emergencyhamnet/meshcore-pi-hat/images/README.md

# Board Images

Add clear photographs and renders here. Identify the board revision and distinguish a render
from a fabricated assembly. Remove private labels and location metadata where appropriate.
