emergencyhamnet/meshcore-pi-hat/LICENSING.md

# Non-Commercial Shared Hardware

## Licence And Scope

Unless explicitly marked otherwise, original project hardware design files, fabrication
outputs, documentation and images are licensed under
[CC BY-NC-SA 4.0](https://creativecommons.org/licenses/by-nc-sa/4.0/legalcode).
See [LICENSE](LICENSE) for the licence notice and official terms.

This permits sharing and adaptations for non-commercial purposes, with attribution and
the applicable ShareAlike requirements. NonCommercial has the definition in the official
licence; it is not simply a restriction on profit. This is not an open-source hardware
licence because commercial use is restricted.

For attribution, retain the project name, credited creators and this repository link:
https://github.com/emergencyhamnet/meshcore-pi-hat
Identify modifications and retain existing notices when sharing adaptations.

## Separate Fabrication Permission

In addition to the CC licence, the project licensors permit users to make or commission
physical boards for their own non-commercial use, to the extent the licensors control
the rights needed for that activity. A fabrication or assembly service may reproduce
and use the supplied design files solely to fulfil those non-commercial build orders
and may charge for its manufacturing services.

This additional permission does not authorise a supplier to use the design to produce
its own commercial product line or to manufacture stock for general commercial resale.
Commercial exploitation outside the CC licence and this additional permission requires
separate permission from the relevant rights holders. Contact the maintainers through a
GitHub issue for commercial-licensing enquiries; do not post confidential information.

This permission is separate from the unmodified CC licence. It does not restrict rights
already granted by that licence or by applicable law. It grants no patent or trademark
rights; obtain any other required rights independently. Manufacturing and the boundary
of non-commercial use may require legal review for a particular activity.

## Third-Party Material And Software

Third-party symbols, footprints, models and other assets retain their own licences.
Do not relabel them as CC BY-NC-SA unless the rights holder permits it. Mark exclusions
and retain their attribution and licence notices. Link to datasheets if permission to
redistribute them is unavailable.

Firmware and software in the separate MeshCore Pi port repository retain their own
licences. This hardware licence does not change their terms.

Contributors must have the rights to publish their submissions under the applicable
terms and identify any third-party material. No CAD files are included in the initial
scaffold; review ownership and notices as files are added.
