emergencyhamnet/meshcore-pi-hat/design/circuit.pdf

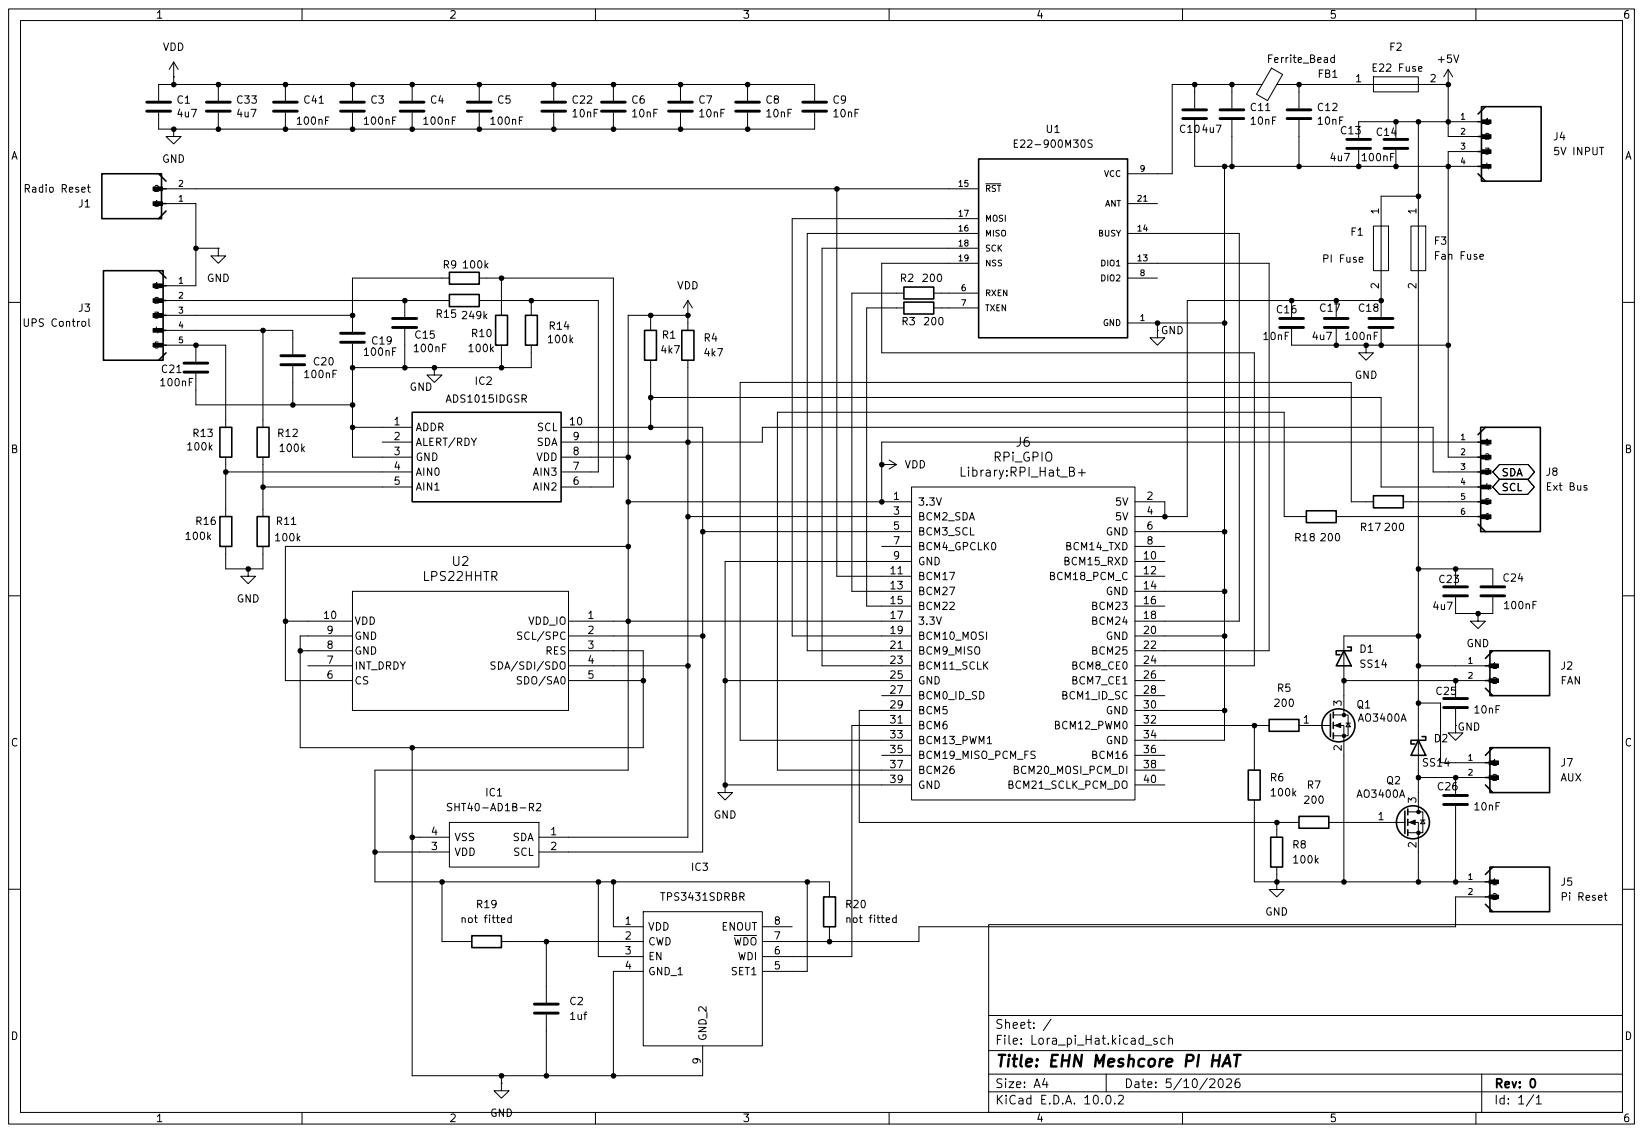
[picture p1: page 1]
