emergencyhamnet/meshcore-pi-hat/design/Lora_pi_Hat.kicad_pcb

## KiCad design design/Lora_pi_Hat.kicad_pcb (2026-11-01)

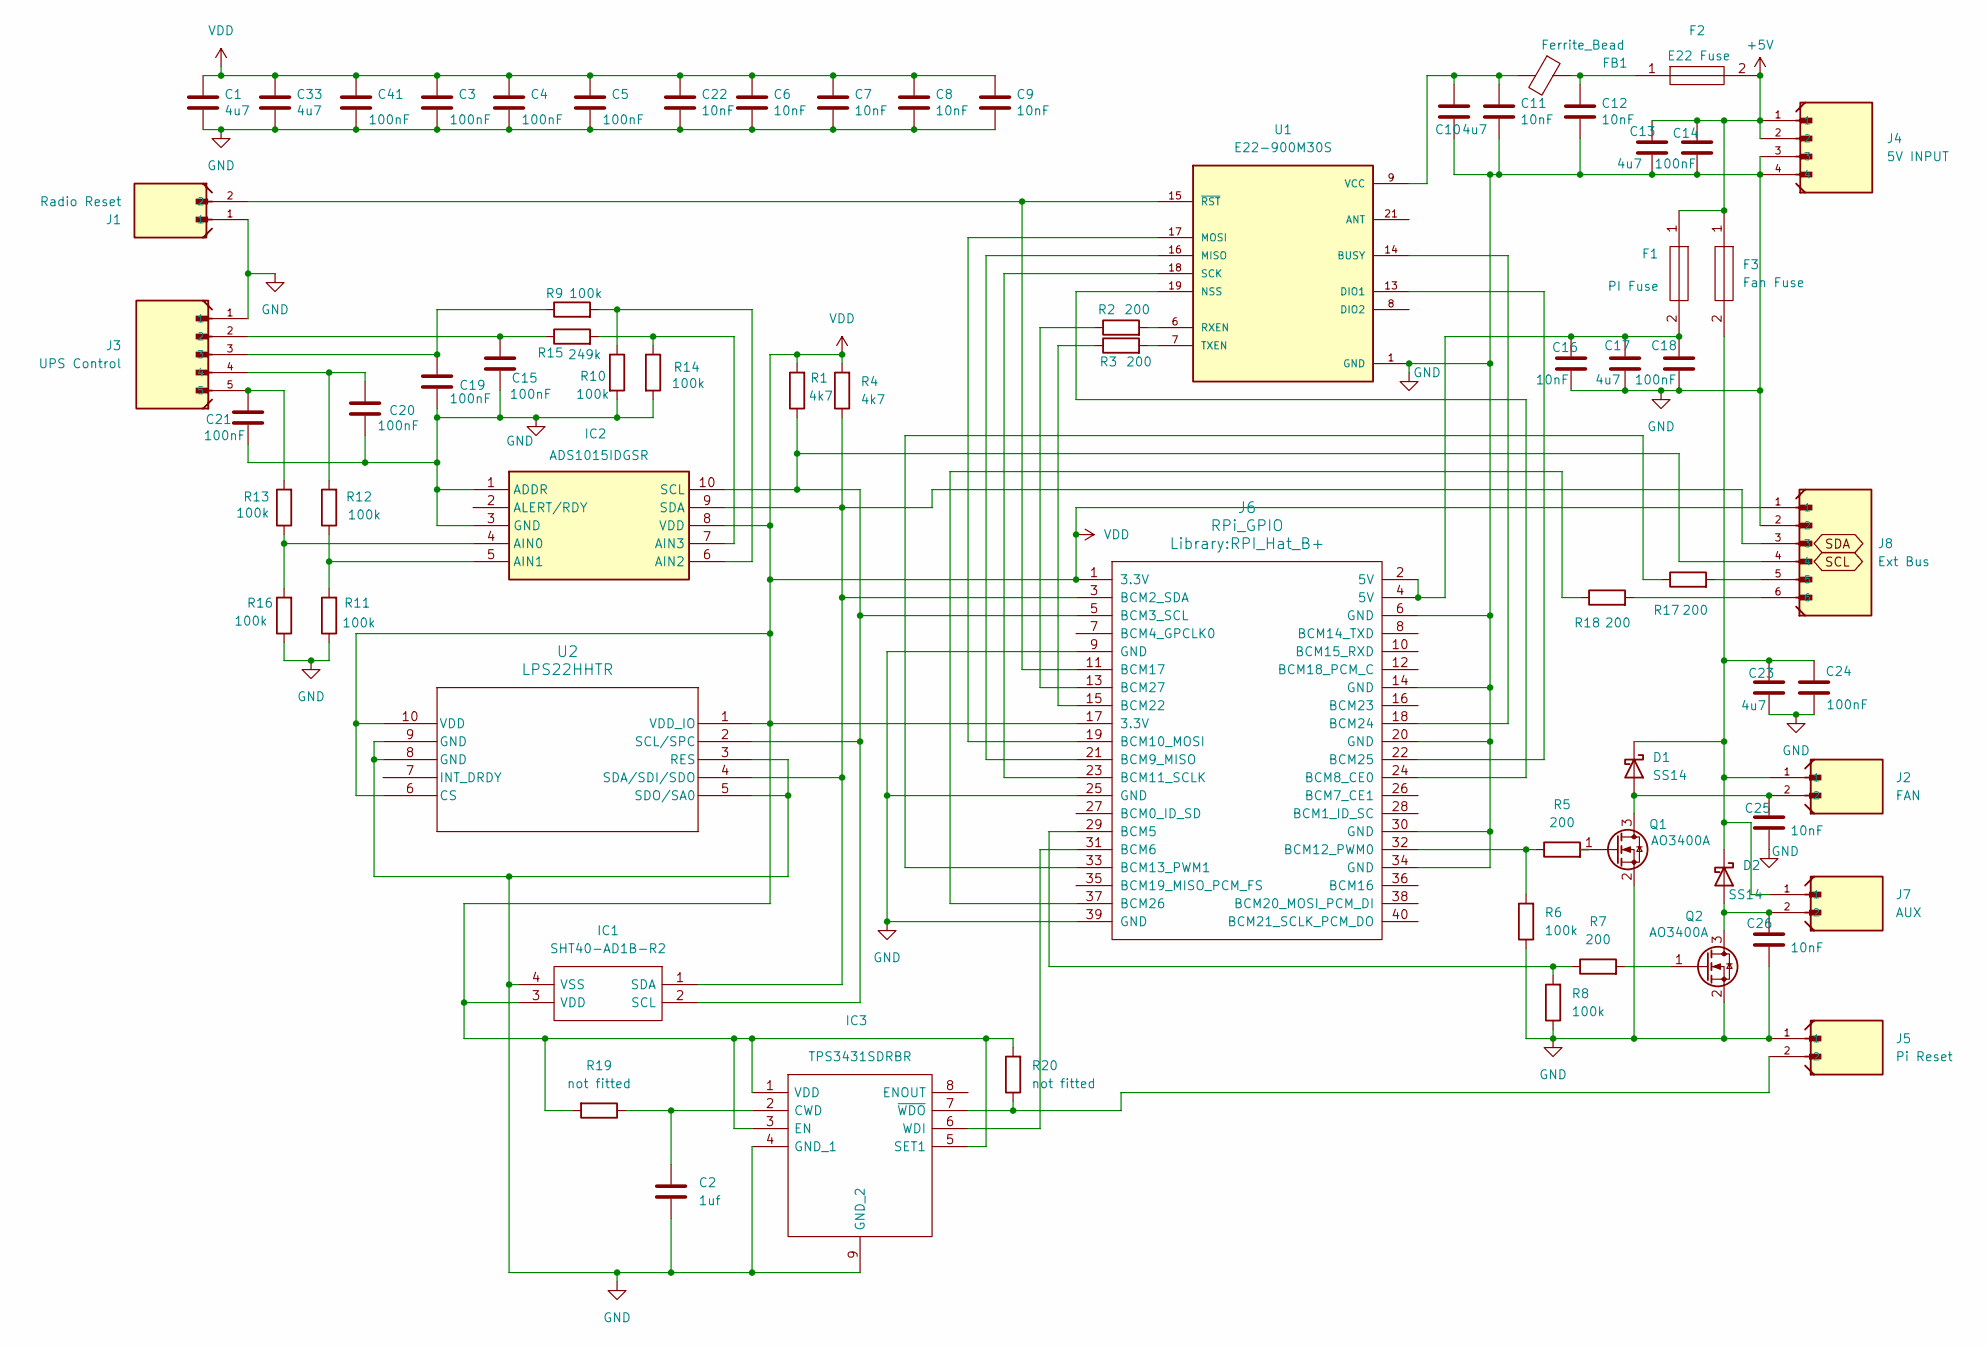
[picture p2: schematic Lora_pi_Hat.kicad_sch, EHN Meshcore PI HAT]

Parts:
C1, C10, C13, C17, C23, C33: 4u7; C_0805_2012Metric_Pad1.15x1.40mm_HandSolder
C2: 1uf; C_0603_1608Metric_Pad1.05x0.95mm_HandSolder
C3, C4, C5, C14, C15, C18, C19, C20, C21, C24, C41: 100nF; C_0603_1608Metric_Pad1.05x0.95mm_HandSolder
C6, C7, C8, C9, C11, C12, C16, C22, C25, C26: 10nF; C_0603_1608Metric_Pad1.05x0.95mm_HandSolder
D1, D2: SS14; D_SMA
F1: PI Fuse; FUSC4632X85N; Mouser Part Number 652-MF-MSMF200-2
F2: E22 Fuse; FUSC4632X85N; Mouser Part Number 652-MF-MSMF200-2
F3: Fan Fuse; FUSC4632X85N; Mouser Part Number 652-MF-MSMF200-2
FB1: Ferrite_Bead; 28F01811SR10
IC1: SHT40-AD1B-R2; SHT4X; Manufacturer_Part_Number SHT40-AD1B-R2; Mouser Part Number 403-SHT40-AD1B-R2
IC2: ADS1015IDGSR; DGS0010A_L; Mouser Part Number 595-ADS1015IDGSR
IC3: TPS3431SDRBR; SON65P300X300X100-9N-D; Mouser Part Number 595-TPS3431SDRBR
J1: Radio Reset; JST_B2B-PH-K-S_LF__SN_
J2: FAN; JST_B2B-PH-K-S_LF__SN_
J3: UPS Control; JST_B5B-PH-K-S
J4: 5V INPUT; JST_B4B-PH-K-S_LF__SN_
J5: Pi Reset; JST_B2B-PH-K-S_LF__SN_
J6: RPi_GPIO; RPI_Hat_B+
J7: AUX; JST_B2B-PH-K-S_LF__SN_
J8: Ext Bus; JST_B6B-PH-K-S
Q1, Q2: AO3400A; SOT-23
R1, R4: 4k7; R_0603_1608Metric_Pad0.98x0.95mm_HandSolder
R2, R3, R5, R7, R17, R18: 200; R_0603_1608Metric_Pad0.98x0.95mm_HandSolder
R6, R8, R9, R10, R11, R12, R13, R14, R16: 100k; R_0603_1608Metric_Pad0.98x0.95mm_HandSolder
R15: 249k; R_0603_1608Metric_Pad0.98x0.95mm_HandSolder
R19, R20: not fitted; R_0603_1608Metric_Pad0.98x0.95mm_HandSolder
U1: E22-900M30S; XCVR_E22-900M30S; PARTREV 1.2
U2: LPS22HHTR; HLGA-10L_2X2X0P73_STM

Connections:
+5V: C13.1, C14.1, F1.1, F2.2, F3.1, J4.1, J4.2
GND: C1.2, C2.2, C3.2, C4.2, C5.2, C6.2, C7.2, C8.2, C9.2, C10.2, C11.2, C12.2, C13.2, C14.2, C15.2, C16.2, C17.2, C18.2, C19.2, C20.2, C21.2, C22.2, C23.2, C24.2, C25.2, C26.2, C33.2, C41.2, IC1.4 (VSS), IC2.1 (ADDR), IC2.3 (GND), IC3.4 (GND_1), IC3.9 (GND_2), J1.1, J3.1, J4.3, J4.4, J5.1, J6.6 (GND), J6.9 (GND), J6.14 (GND), J6.20 (GND), J6.25 (GND), J6.30 (GND), J6.34 (GND), J6.39 (GND), J8.2, Q1.2 (S), Q2.2 (S), R6.1, R8.1, R10.2, R11.1, R14.2, R16.1, U1.1 (GND), U1.2 (GND), U1.3 (GND), U1.4 (GND), U1.5 (GND), U1.11 (GND), U1.12 (GND), U1.20 (GND), U1.22 (GND), U2.3 (RES), U2.5 (SDO/SA0), U2.8 (GND), U2.9 (GND)
unnamed: C12.1, F2.1, FB1.1
unnamed: C15.1, J3.2, R15.1
unnamed: C16.1, C17.1, C18.1, F1.2, J6.2 (5V), J6.4 (5V)
unnamed: C19.1, J3.3, R9.1
unnamed: C20.1, J3.4, R12.2
unnamed: C21.1, J3.5, R13.2
unnamed: C25.1, D1.2 (A), J2.2, Q1.3 (D)
unnamed: C23.1, C24.1, D1.1 (K), D2.1 (K), F3.2, J2.1, J7.1
unnamed: C26.1, D2.2 (A), J7.2, Q2.3 (D)
unnamed: IC1.2 (SCL), IC2.10 (SCL), J6.5 (BCM3_SCL), J8.4, R1.1, U2.2 (SCL/SPC)
unnamed: IC1.1 (SDA), IC2.9 (SDA), J6.3 (BCM2_SDA), J8.3, R4.1, U2.4 (SDA/SDI/SDO)
unnamed: IC2.4 (AIN0), R13.1, R16.2
unnamed: IC2.5 (AIN1), R11.2, R12.1
unnamed: IC2.6 (AIN2), R9.2, R10.1
unnamed: IC2.7 (AIN3), R14.1, R15.2
unnamed: C2.1, IC3.2 (CWD), R19.1
unnamed: IC3.6 (WDI), J6.31 (BCM6)
unnamed: IC3.7 (~WDO), J5.2, R20.1
unnamed: J6.29 (BCM5), R7.1, R8.2
unnamed: J6.24 (BCM8_CE0), U1.19 (NSS)
unnamed: J6.21 (BCM9_MISO), U1.16 (MISO)
unnamed: J6.19 (BCM10_MOSI), U1.17 (MOSI)
unnamed: J6.23 (BCM11_SCLK), U1.18 (SCK)
unnamed: J6.32 (BCM12_PWM0), R5.1, R6.2
unnamed: J6.33 (BCM13_PWM1), R17.1
unnamed: J1.2, J6.11 (BCM17), U1.15 (~RST)
unnamed: J6.15 (BCM22), R3.1
unnamed: J6.18 (BCM24), U1.14 (BUSY)
unnamed: J6.22 (BCM25), U1.13 (DIO1)
unnamed: J6.37 (BCM26), R18.1
unnamed: J6.13 (BCM27), R2.1
unnamed: J8.5, R17.2
unnamed: J8.6, R18.2
unnamed: Q1.1 (G), R5.2
unnamed: Q2.1 (G), R7.2
unnamed: R2.2, U1.6 (RXEN)
unnamed: R3.2, U1.7 (TXEN)
VCC: C10.1, C11.1, FB1.2, U1.9 (VCC), U1.10 (VCC)
VDD: C1.1, C3.1, C4.1, C5.1, C6.1, C7.1, C8.1, C9.1, C22.1, C33.1, C41.1, IC1.3 (VDD), IC2.8 (VDD), IC3.1 (VDD), IC3.3 (EN), IC3.5 (SET1), J6.1 (3.3V), J6.17 (3.3V), J8.1, R1.2, R4.2, R19.2, R20.2, U2.1 (VDD_IO), U2.6 (CS), U2.10 (VDD)

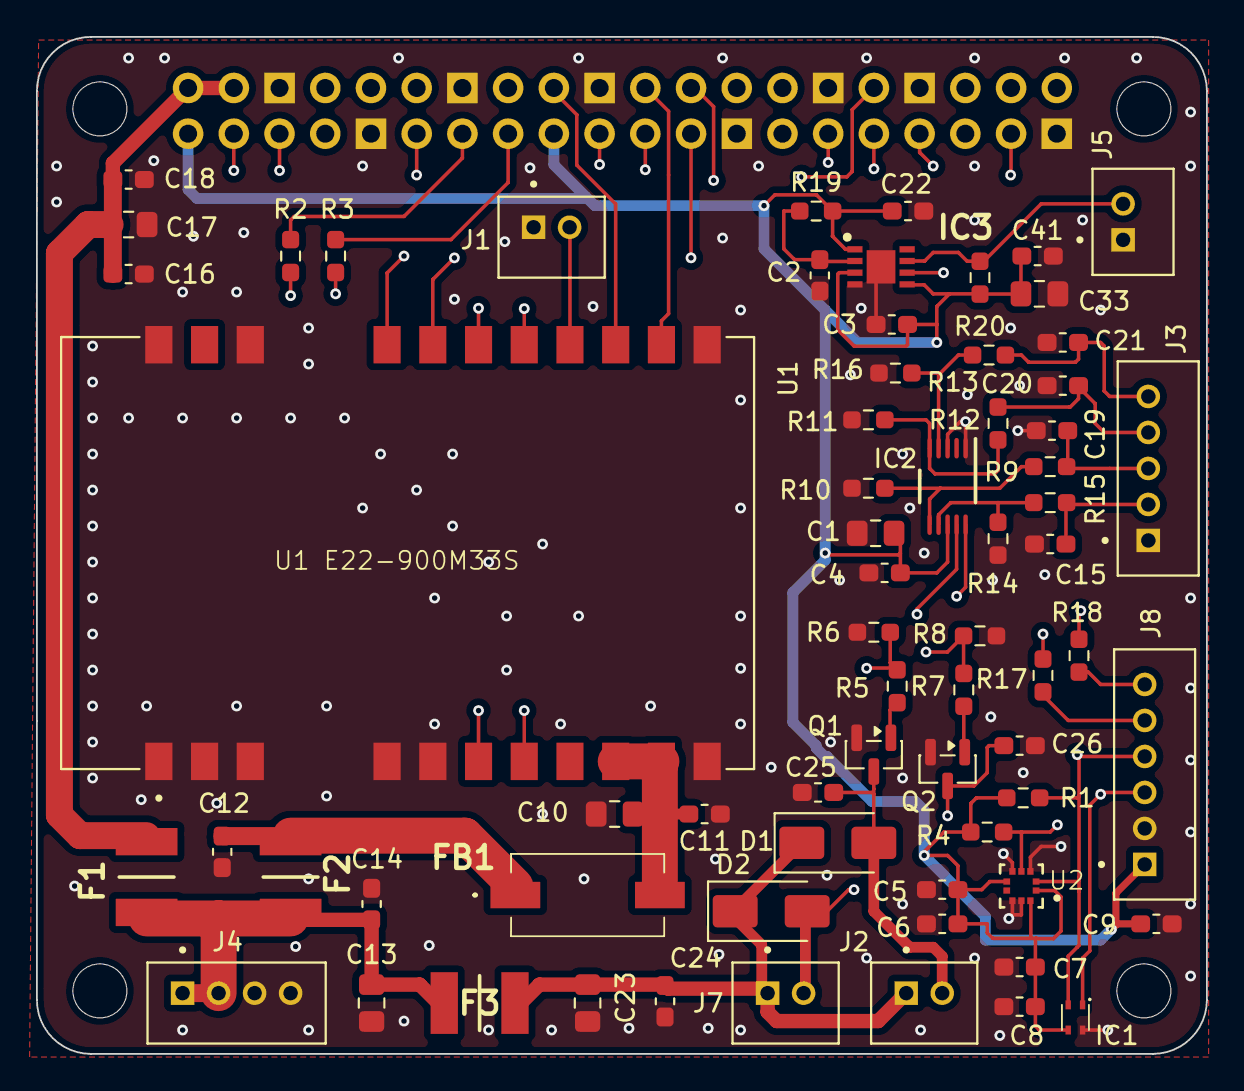
[picture p3: board Lora_pi_Hat.kicad_pcb from above]

Board: 4 copper layers, 65.0 x 56.5 mm, 69 parts (0 on the bottom side), 41 nets.
