emergencyhamnet/meshcore-pi-hat/CHANGELOG.md

# Changelog

## hardware-v1.0 - 2026-11-01

- Added the original fab-submitted Gerber/drill/BOM package for the Issue 1.0 HAT.
- Added editable KiCad project, schematic and PCB, schematic PDF, hardware spec and BOM.
- Documented the original build's hand-soldered fuse workaround and the later,
	fabrication-untested fuse-pad changes in the current PCB source.
- Recorded the original ZIP checksum and BOM/module selection caveats.

## Initial Scaffold

- Original hardware design and documentation licensed under CC BY-NC-SA 4.0, with
	separate paid-fabrication permission for non-commercial builds.
