emergencyhamnet/meshcore-pi-hat/design/MeshCore_Pi_HAT_Hardware_Spec_Issue_1_0.rtf

MeshCore Raspberry Pi HAT Hardware Specification
Issue:1.0
Release Date:2026-05-13
Project:Raspberry Pi 3B / Pi 4 MeshCore HAT with E22-900M33S radio

1. Purpose
This document defines the hardware interface for the MeshCore Raspberry Pi HAT design. It captures the major components, power architecture, connector pinouts, Raspberry Pi GPIO assignments, I2C device addresses, ADC input scaling, watchdog interface, and software-relevant control signals.

The document is intended to support final schematic review, PCB checking, firmware/software development, and field documentation.

2. Major Components
Radio: E22-900M33S, using compatible E22-900M30S symbol/footprint
Pressure sensor: LPS22HHTR
Temp/humidity: SHT40-AD1B-R2
ADC: ADS1015IDGSR
Watchdog: TPS3431SDRBR
E22 eFuse: TPS259531DSGT
Fan switch: Logic-level N-MOSFET, e.g. AO3400A
Fan diode: SS14 Schottky diode
HAT EEPROM: Not fitted

3. System Power Architecture
External 5V input enters through J4.
J4 pin 1: 5V input
J4 pin 2: 5V input
J4 pin 3: GND
J4 pin 4: GND

The HAT distributes 5V into separate functional branches:
5V_PI: Protected 5V feed to Raspberry Pi header pins 2 and 4
5V_E22: Protected 5V feed to E22-900M33S radio module
5V_FAN: 5V fan output supply

The Raspberry Pi 3.3V rail powers low-current logic only:
SHT40 sensor
LPS22HH sensor
ADS1015 ADC
TPS3431 watchdog
I2C pullups
J8 external bus 3.3V pin

All grounds are common.

4. Raspberry Pi GPIO Assignment
Pin 1 3V3 -> 3V3 logic rail
Pin 2 5V -> 5V_PI
Pin 3 GPIO2 -> I2C1_SDA
Pin 4 5V -> 5V_PI
Pin 5 GPIO3 -> I2C1_SCL
Pin 6 GND -> GND
Pin 7 GPIO4 -> Not used
Pin 8 GPIO14 -> Not used
Pin 9 GND -> GND
Pin 10 GPIO15 -> Not used
Pin 11 GPIO17 -> LORA_NRST and J1 pin 2 radio reset
Pin 12 GPIO18 -> Not used
Pin 13 GPIO27 -> LORA_RXEN
Pin 14 GND -> GND
Pin 15 GPIO22 -> LORA_TXEN
Pin 16 GPIO23 -> Not used
Pin 17 3V3 -> 3V3 logic rail
Pin 18 GPIO24 -> LORA_BUSY
Pin 19 GPIO10 -> SPI0_MOSI / LORA_MOSI
Pin 20 GND -> GND
Pin 21 GPIO9 -> SPI0_MISO / LORA_MISO
Pin 22 GPIO25 -> LORA_DIO1
Pin 23 GPIO11 -> SPI0_SCLK / LORA_SCK
Pin 24 GPIO8 -> SPI0_CE0 / LORA_NSS
Pin 25 GND -> GND
Pin 26 GPIO7 -> Not used
Pin 27 GPIO0 -> Not used; HAT EEPROM not fitted
Pin 28 GPIO1 -> Not used; HAT EEPROM not fitted
Pin 29 GPIO5 -> Not used
Pin 30 GND -> GND
Pin 31 GPIO6 -> TPS3431 watchdog WDI heartbeat
Pin 32 GPIO12 -> Fan / switched output PWM control
Pin 33 GPIO13 -> J8 external bus pin 5
Pin 34 GND -> GND
Pin 35 GPIO19 -> Not used
Pin 36 GPIO16 -> Not used
Pin 37 GPIO26 -> J8 external bus pin 6
Pin 38 GPIO20 -> Not used
Pin 39 GND -> GND
Pin 40 GPIO21 -> Not used

5. E22-900M33S Radio Interface
Power:
E22 VCC pins -> 5V_E22 protected branch
E22 GND pins -> GND

SPI and control:
E22 MOSI -> Pi GPIO10, physical pin 19, SPI0_MOSI
E22 MISO -> Pi GPIO9, physical pin 21, SPI0_MISO
E22 SCK -> Pi GPIO11, physical pin 23, SPI0_SCLK
E22 NSS -> Pi GPIO8, physical pin 24, SPI0_CE0
E22 DIO1 -> Pi GPIO25, physical pin 22
E22 BUSY -> Pi GPIO24, physical pin 18
E22 NRST -> Pi GPIO17, physical pin 11, and J1 pin 2
E22 TXEN -> Pi GPIO22, physical pin 15
E22 RXEN -> Pi GPIO27, physical pin 13
E22 DIO2 -> RF switch control option/test pad if fitted

RF:
The E22 module's own RF connector is used.
The E22 ANT pad is left unconnected.

Software notes:
SPI bus: SPI0
Chip select: CE0
Reset GPIO: GPIO17, active low at radio reset input
IRQ GPIO: GPIO25 from DIO1
Busy GPIO: GPIO24
TX enable GPIO: GPIO22
RX enable GPIO: GPIO27

6. I2C Bus
Bus name: I2C1
SDA: Pi GPIO2, physical pin 3
SCL: Pi GPIO3, physical pin 5
Pullups: One 4.7k pullup from SDA to 3V3, one 4.7k pullup from SCL to 3V3

Connected devices:
SHT40-AD1B-R2 Temperature/humidity sensor
LPS22HHTR Barometric pressure sensor
ADS1015IDGSR ADC for VIN, VOUT, AUX, VBAT
J8 External I2C expansion bus

I2C addresses:
SHT40 0x44
LPS22HH 0x5C when SA0/SDO is tied to GND
ADS1015 0x48 when ADDR is tied to GND
HAT EEPROM Not fitted

7. SHT40-AD1B-R2 Temperature and Humidity Sensor
VDD -> 3V3
VSS/GND -> GND
SDA -> I2C1_SDA
SCL -> I2C1_SCL
I2C address -> 0x44
Decoupling -> 100nF from VDD to GND close to device

Software data:
Measurements -> Temperature and relative humidity
Bus -> I2C1

8. LPS22HHTR Barometric Pressure Sensor
Pin 1 VDD_IO -> 3V3
Pin 2 SCL/SPC -> I2C1_SCL
Pin 3 RES -> GND
Pin 4 SDA/SDI/SDO -> I2C1_SDA
Pin 5 SDO/SA0 -> GND for address 0x5C
Pin 6 CS -> 3V3 for I2C mode
Pin 7 INT_DRDY -> NC or test pad
Pin 8 GND -> GND
Pin 9 GND -> GND
Pin 10 VDD -> 3V3

Decoupling:
100nF from VDD_IO to GND close to device
100nF from VDD to GND close to device
Optional 1uF on 3V3 nearby

Software data:
Measurements -> Barometric pressure and sensor temperature if required
Bus -> I2C1
I2C address -> 0x5C

9. ADS1015IDGSR ADC
VDD -> 3V3
GND -> GND
SDA -> I2C1_SDA
SCL -> I2C1_SCL
ADDR -> GND for I2C address 0x48
ALERT/RDY -> NC or test pad
AIN0 -> VIN divider midpoint
AIN1 -> VOUT divider midpoint
AIN2 -> AUX divider midpoint
AIN3 -> VBAT divider midpoint
Decoupling -> 100nF from VDD to GND close to device

ADC input connector J3:
J3 pin 1 -> GND
J3 pin 2 -> VBAT input
J3 pin 3 -> AUX input
J3 pin 4 -> VOUT input
J3 pin 5 -> VIN input

Divider networks:
VIN: J3 pin 5 -> 100k -> AIN0 -> 100k -> GND
VOUT: J3 pin 4 -> 100k -> AIN1 -> 100k -> GND
AUX: J3 pin 3 -> 100k -> AIN2 -> 100k -> GND
VBAT: J3 pin 2 -> 100k -> AIN3 -> 249k -> GND

Optional filtering:
100nF from each ADS1015 input midpoint to GND.

Software conversion multipliers:
VIN volts = ADS_AIN0_voltage * 2.000
VOUT volts = ADS_AIN1_voltage * 2.000
AUX volts = ADS_AIN2_voltage * 2.000
VBAT volts = ADS_AIN3_voltage * 1.402

Software notes:
Bus -> I2C1
I2C address -> 0x48
Expected VBAT -> Single Li-ion cell, approximately 2.75V to 4.20V
Expected VIN/VOUT -> Nominal 5V rails

10. TPS3431SDRBR Watchdog
Pin 1 VDD -> 3V3
Pin 2 CWD -> Watchdog timeout capacitor to GND
Pin 3 EN -> 3V3, direct or 100k pullup
Pin 4 GND -> GND
Pin 5 SET1 -> 3V3
Pin 6 WDI -> Pi GPIO6, physical pin 31
Pin 7 WDO -> J5 pin 2, open-drain reset output
Pin 8 ENOUT -> NC or test pad

Watchdog timing:
CWD = 1uF gives approximately 77s watchdog timeout.

Pi reset connector J5:
J5 pin 1 -> GND
J5 pin 2 -> TPS3431 WDO reset output

External reset wire:
Pi 3B -> J5 pin 2 to Pi RUN pad/header
Pi 4 -> J5 pin 2 to Pi GLOBAL_EN pad/header

Software behavior:
GPIO6 should be toggled periodically by software after boot.
Recommended heartbeat interval: 10s to 20s.
If heartbeat stops for the watchdog timeout period, WDO pulls low and resets the Pi through J5.

11. Fan and Auxiliary Switched Outputs
Fan connector J2:
J2 pin 1 -> 5V_FAN
J2 pin 2 -> Switched fan negative / MOSFET drain

Auxiliary output J7:
J7 pin 1 -> 5V
J7 pin 2 -> Switched output

Fan and Aux switch:
MOSFET source -> GND
MOSFET gate -> Pi GPIO through 200-ohm resistor
Gate pulldown -> 100k from GPIO to GND
Flyback diode -> SS14; cathode to J2/J7 pin 1, anode to J2 pin 2
Fan tach -> Not used

Software behavior:
GPIO12 controls Fan/switch PWM or on/off output depending on software configuration.
GPIO5 controls Aux/switch PWM or on/off output depending on software configuration
Recommended fan control should use hysteresis to avoid rapid cycling.

12. TPS259531DSGT E22 eFuse
Function: Protected 5V_E22 branch for E22 radio power
IN -> 5V input after main input protection
OUT -> 5V_E22 branch, then optional ferrite bead and radio bulk capacitance
GND -> GND
ILM -> 1.02k 1% to GND, approximately 2A current limit
dVdt -> 47nF to GND
EN/UVLO -> Tie to IN for always-on operation unless controlled enable is required
FLT -> Optional 10k pullup to 3V3 and optional test point/GPIO for fault reporting
CIN -> 1uF plus 100nF near IN to GND
COUT -> 10uF near OUT to GND

Radio bulk capacitance:
470uF to 1000uF, 10V, low ESR, placed near E22 power pins
10uF,and 100nF local ceramic capacitors near E22 VCC/GND

13. External Connectors
J1 radio reset:
Pin 1 -> GND
Pin 2 -> Pi GPIO17 and E22 RST / NRST net

J2 fan:
Pin 1 -> 5V
Pin 2 -> Switched output / MOSFET drain

J3 ADC input connector:
Pin 1 -> GND
Pin 2 -> VBAT
Pin 3 -> AUX
Pin 4 -> VOUT
Pin 5 -> VIN

J4 power connector:
Pin 1 -> 5V input
Pin 2 -> 5V input
Pin 3 -> GND
Pin 4 -> GND

J5 Pi reset:
Pin 1 -> GND
Pin 2 -> TPS3431 WDO reset output to Pi RUN/GLOBAL_EN

J7 auxiliary switched output:
Pin 1 -> 5V
Pin 2 -> Switched output / MOSFET drain

J8 external bus:
Pin 1 -> 3V3
Pin 2 -> GND
Pin 3 -> SDA / I2C1_SDA
Pin 4 -> SCL / I2C1_SCL
Pin 5 -> GPIO13
Pin 6 -> GPIO26

14. Software Interface Summary
SPI radio:
Bus -> SPI0
CS -> CE0 / GPIO8
MOSI -> GPIO10
MISO -> GPIO9
SCLK -> GPIO11
Reset -> GPIO17
DIO1 IRQ -> GPIO25
BUSY -> GPIO24
TXEN -> GPIO22
RXEN -> GPIO27

I2C bus:
Bus -> I2C1
SDA -> GPIO2
SCL -> GPIO3
SHT40 address -> 0x44
LPS22HH address -> 0x5C
ADS1015 address -> 0x48

ADC channels:
ADS1015 AIN0 -> VIN, multiplier 2.000
ADS1015 AIN1 -> VOUT, multiplier 2.000
ADS1015 AIN2 -> AUX, multiplier 2.000
ADS1015 AIN3 -> VBAT, multiplier 1.402

Watchdog:
WDI heartbeat -> GPIO6
Recommended kick -> Toggle every 10s to 20s
Timeout hardware -> Approximately 77s with 1uF CWD

Fan / switched output:
Control GPIO -> GPIO12
Mode -> PWM or on/off, software-defined

Expansion bus:
J8 GPIO13 -> Available to software
J8 GPIO26 -> Available to software
