emergencyhamnet/meshcore-pi-hat/(commit log)

2026-11-01 Initialize non-commercial shared Pi HAT hardware repository
    Add design, fabrication, BOM, mechanical and documentation scaffold under CC BY-NC-SA 4.0 with separate permission for paid fabrication of non-commercial builds. No CAD files or fabrication release included yet.
    [BOM.template.csv]
2026-11-01 Document hardware-v1.0 fabrication release and revision caveats
    Record the unchanged original fabrication ZIP checksum, working-board fuse assembly workaround, untested revised fuse-pad layout, and BOM/module procurement caveats.
